laurapreidewe/Agriculture-VCU_v1/docs/Revision List.docx

Tractor VCU PCB Revision

Changes Made | Previous PCB | Current PCB

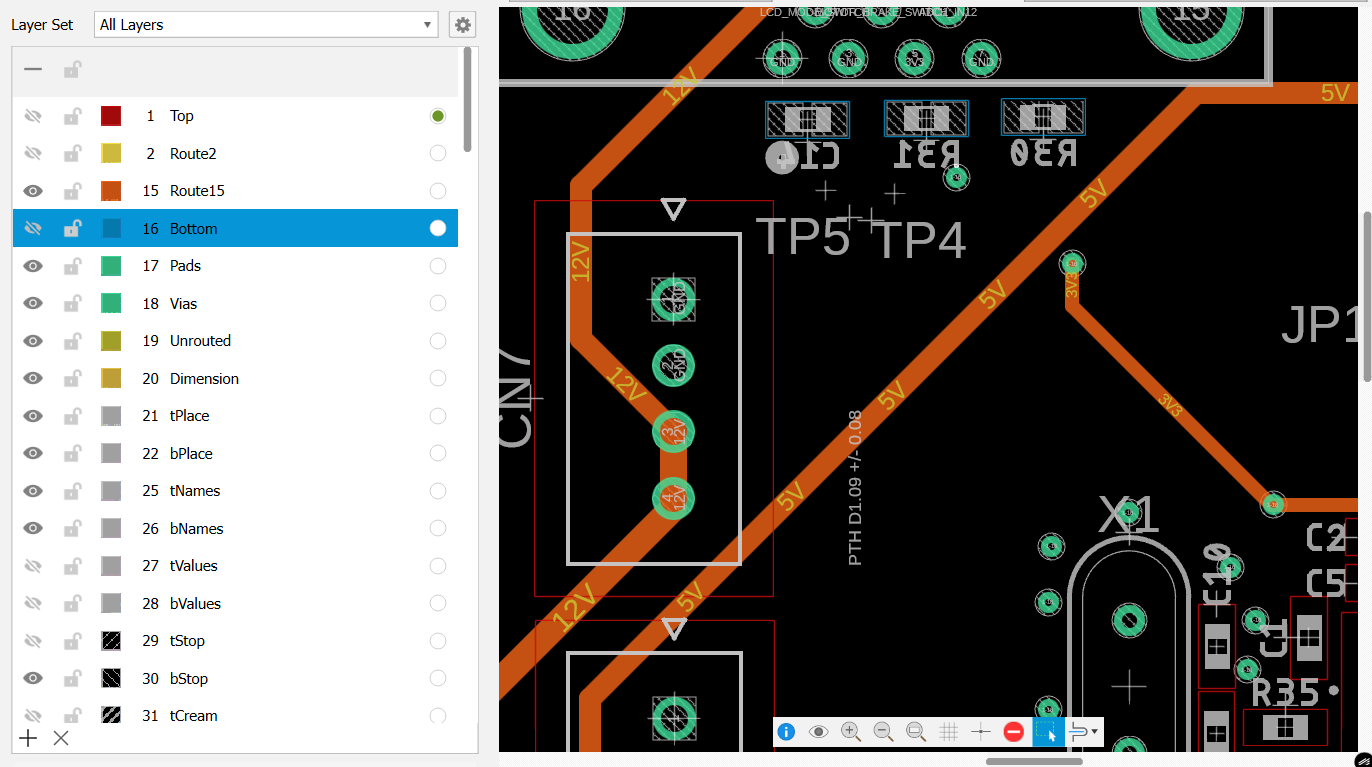
[picture p1: figure]
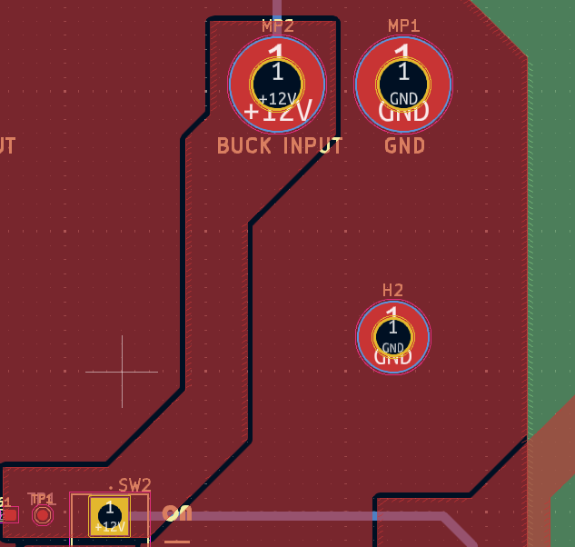
[picture p2: figure]
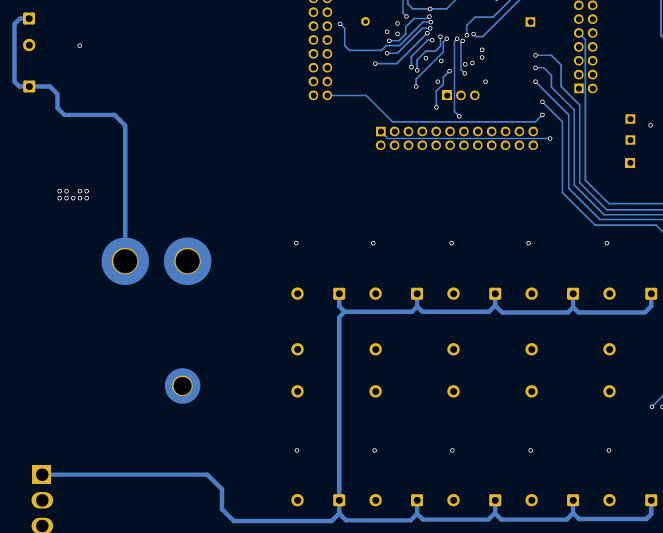
[picture p3: figure]

Move 12V route to outer layer¹ | (Circled in light blue)

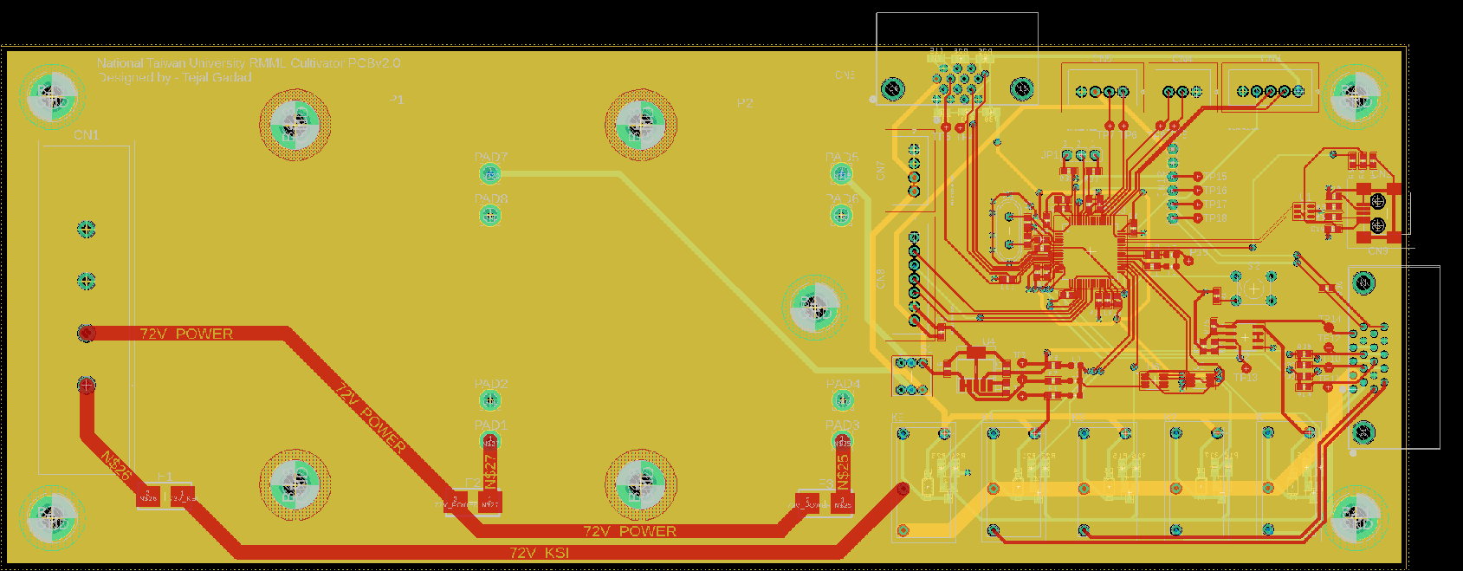
[picture p4: figure]
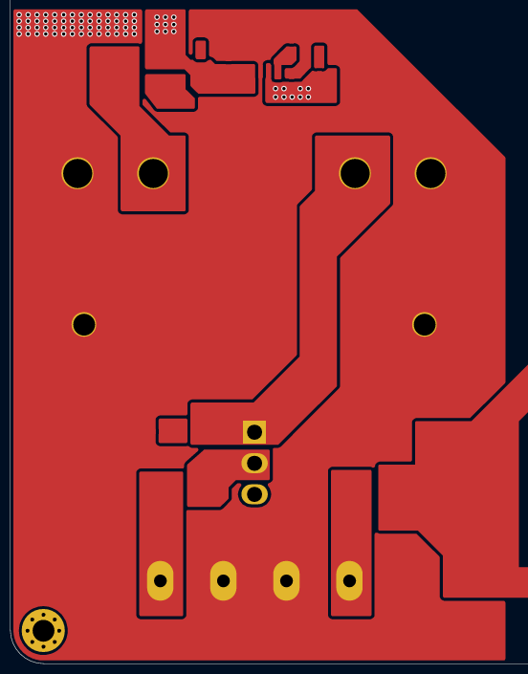
[picture p5: figure]
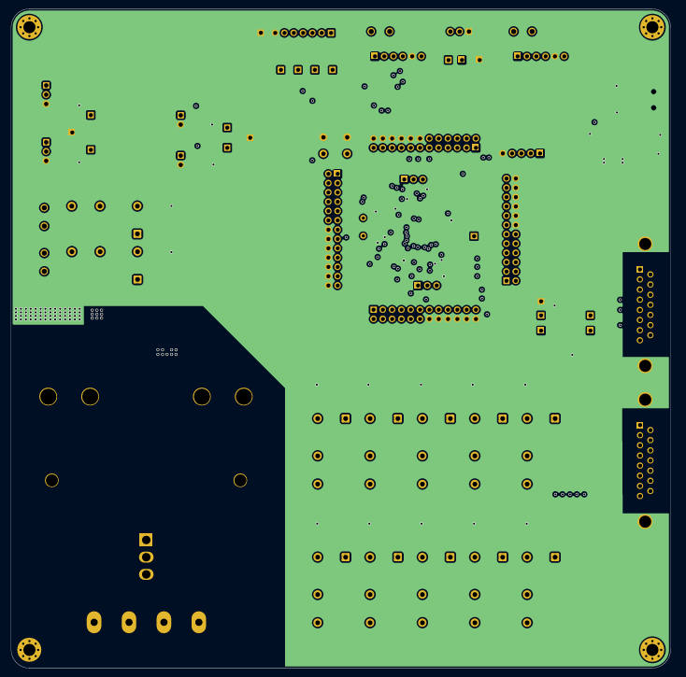
[picture p6: figure]

Separate ground plane for high and low-current¹ | | High current: Low current:

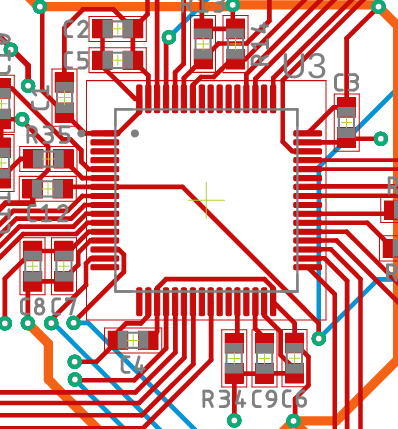
[picture p7: figure]
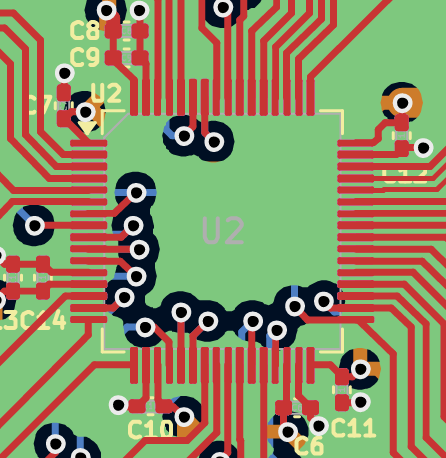
[picture p8: figure]

Component placement (STM32 decoupling capacitors) ¹²
Capacitor footprint size for STM32 circuit | 0603 | 0402
Resistor footprint size for STM32 circuit | 0603 | 0402

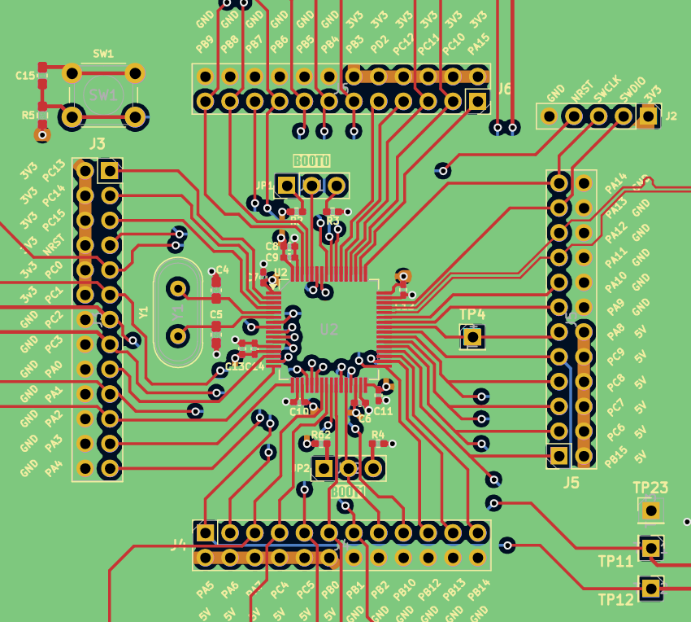
[picture p9: figure]

Add extension pins | N/A

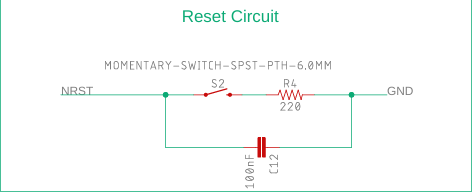
[picture p10: figure]
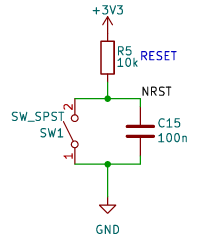
[picture p11: figure]

Fix reset circuit

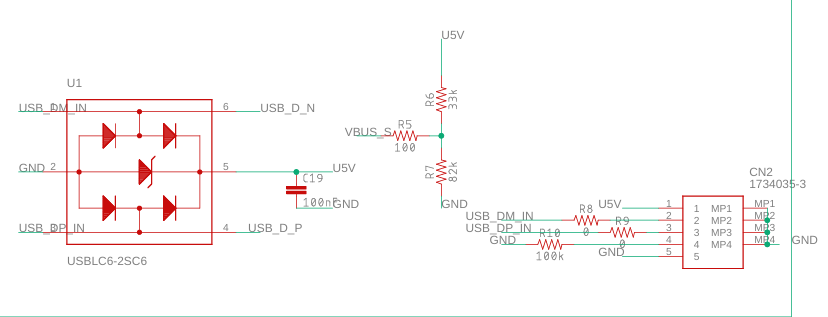
[picture p12: figure]
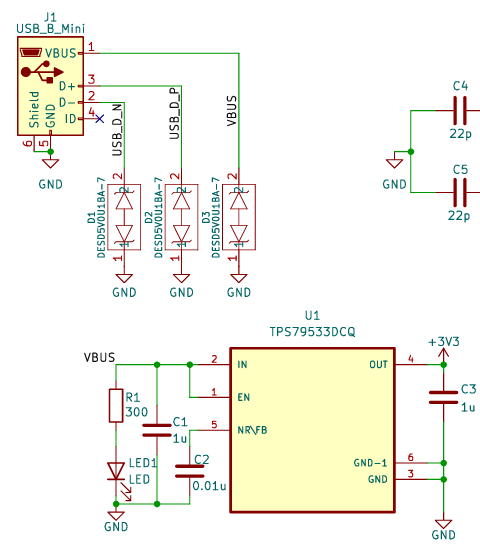
[picture p13: figure]

USB Circuit

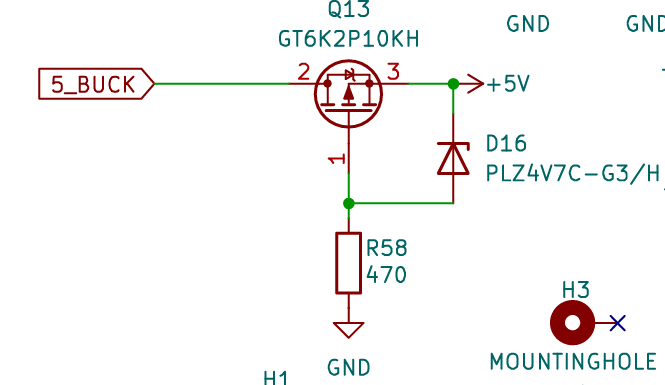
[picture p14: figure]

Add protection circuit (reverse voltage) | N/A
Add a ground point for test points³ | N/A

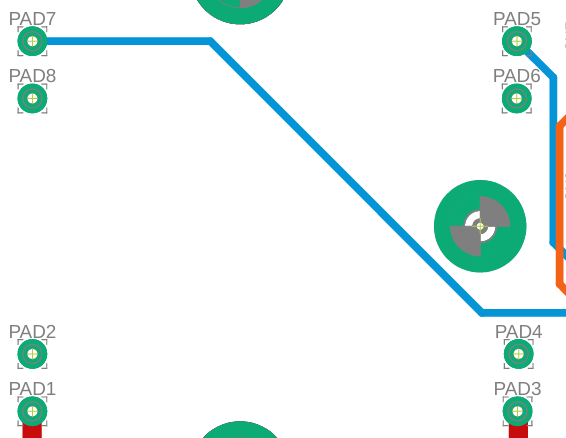
[picture p15: figure]
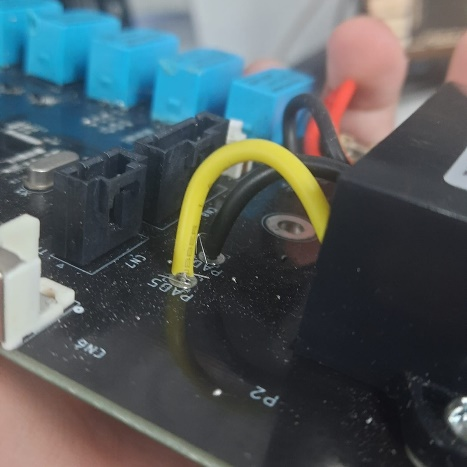
[picture p16: figure]
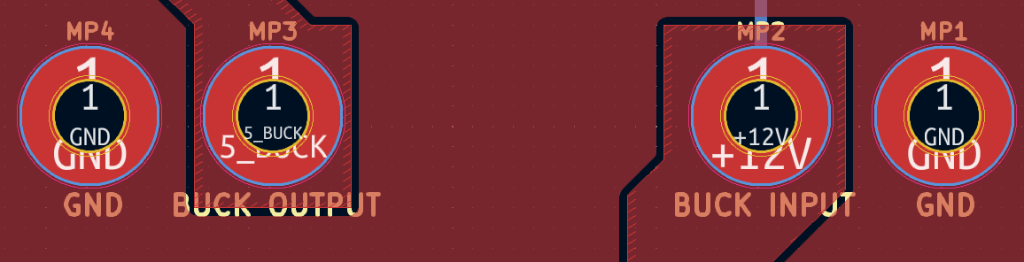
[picture p17: figure]
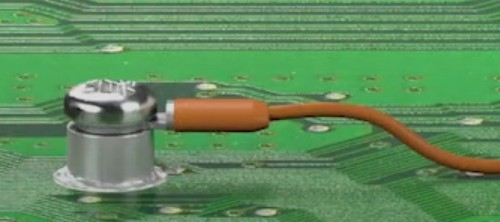
[picture p18: figure]

Change buck converters input and output connector | Connecting method: | Connecting method:

Notes:

¹Layer stacking:

Red: Top -> Signal + Power

Green: Inner layer 1 -> Ground

Orange: Inner layer 2 -> Power

Blue: Bottom -> Signal + Power

²Schematic for STM32 decoupling capacitors

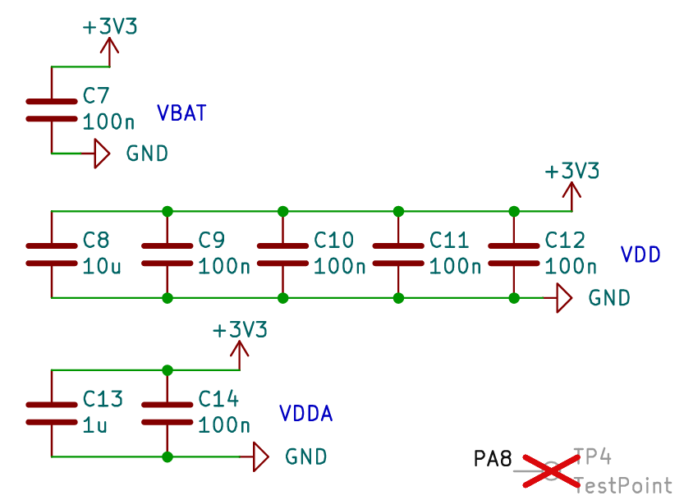
[picture p19: figure]

³Red cross is feature from KiCad to mark a component which is assigned as DNP (Do Not Place)
