laurapreidewe/Agriculture-VCU_v1/(list of files, cad)

Other CAD files:
Tractor VCU.step
