laurapreidewe/Agriculture-VCU_v1/Tractor VCU.kicad_pcb

## KiCad design Tractor VCU.kicad_pcb (2026-10-21)

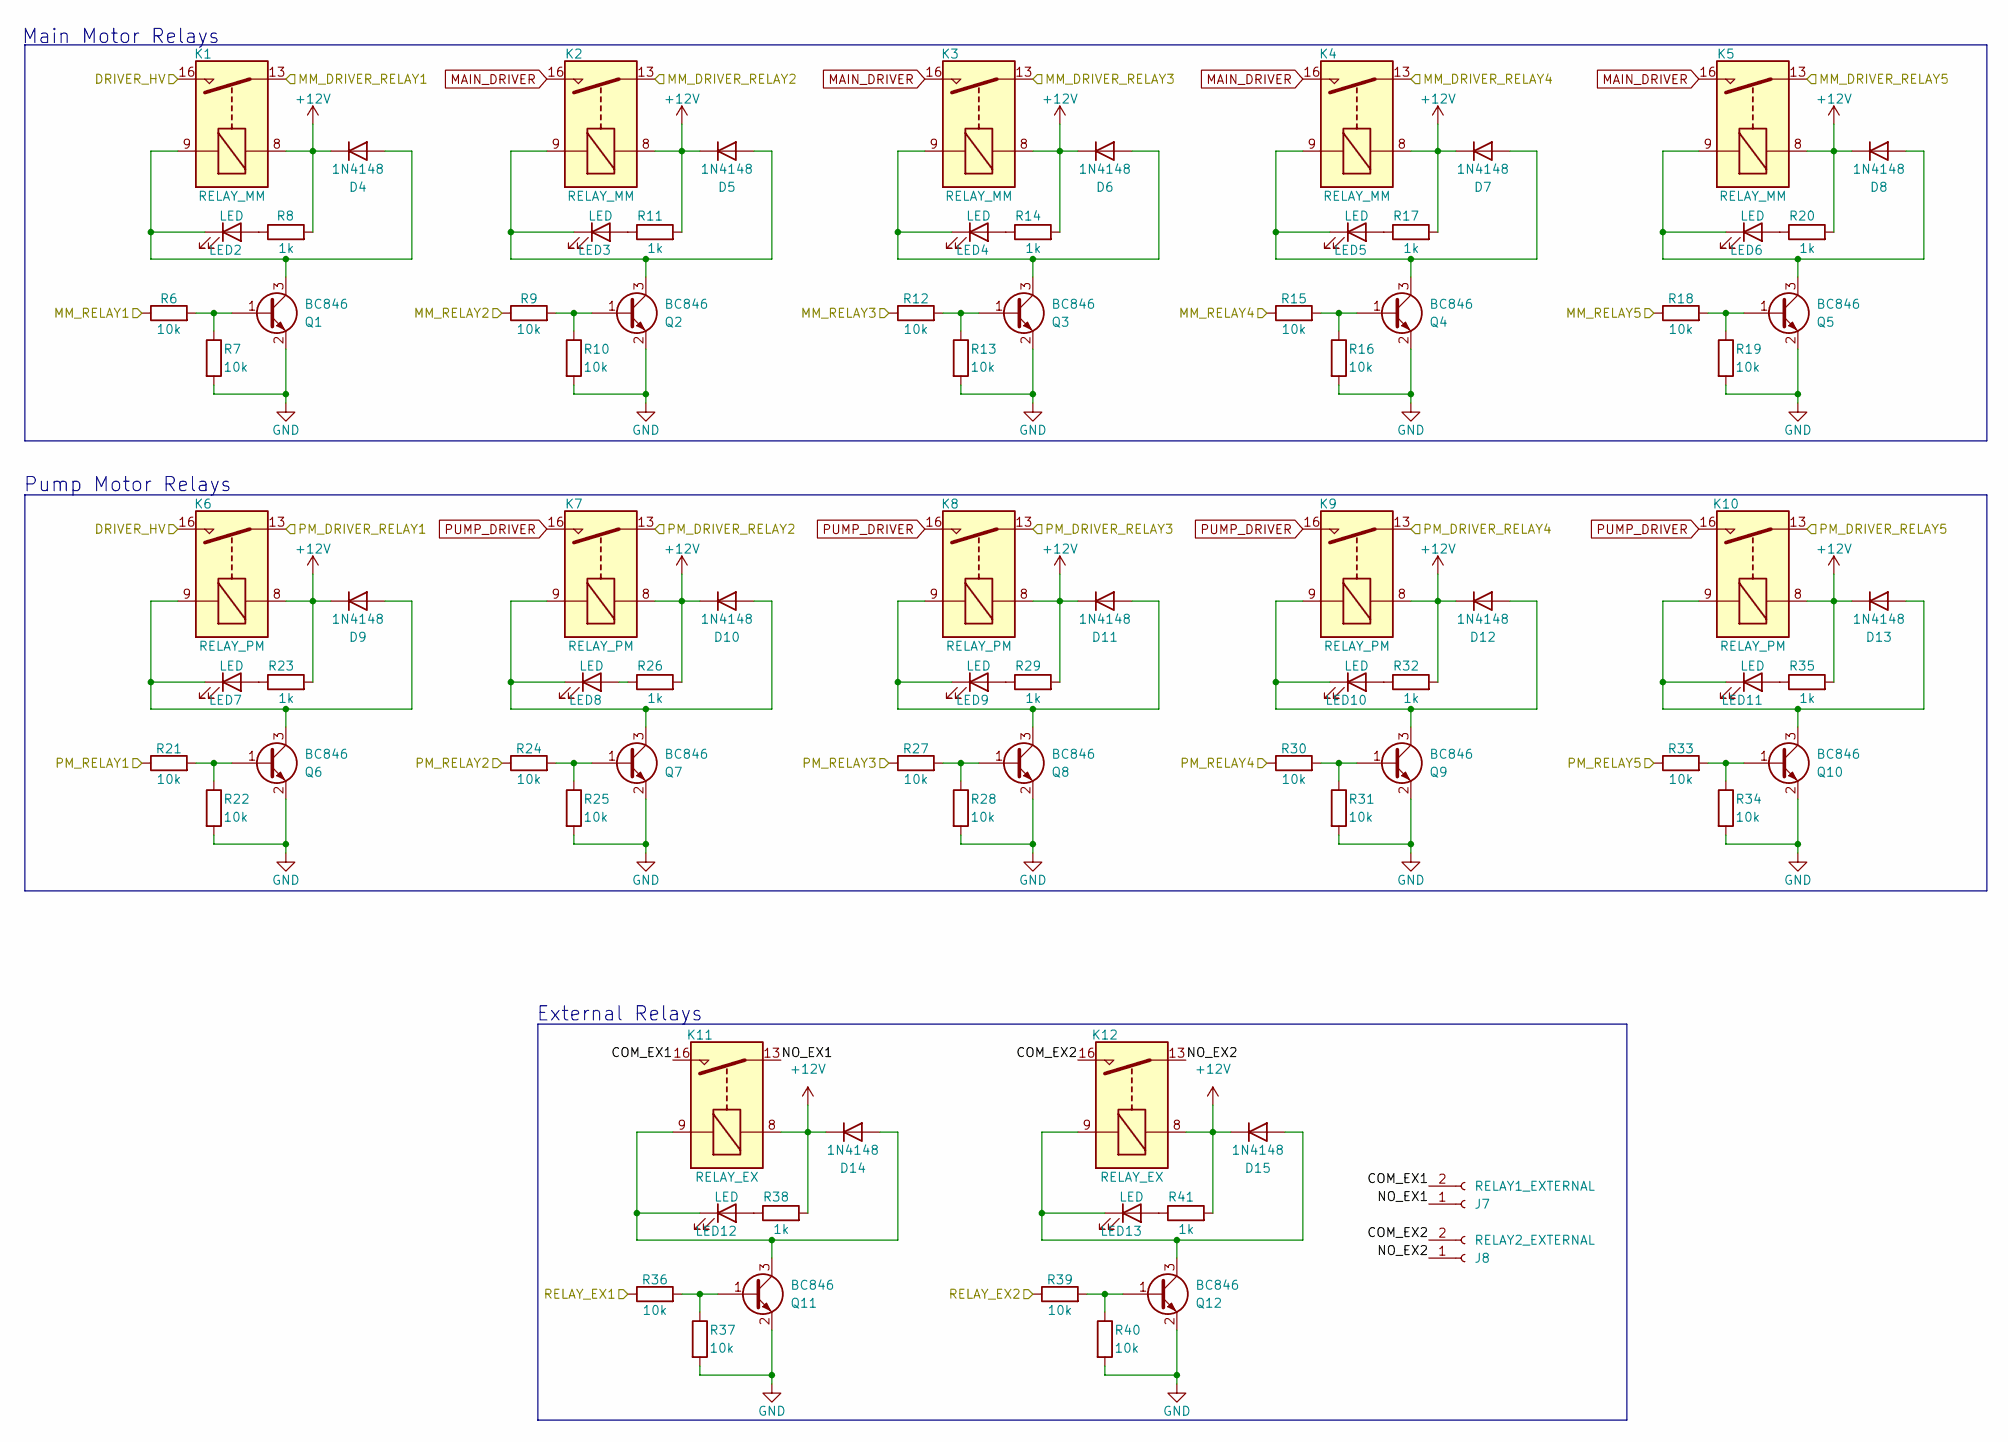
[picture p28: schematic VCU Relays.kicad_sch, Agriculture VCU]

Parts:
D4, D5, D6, D7, D8, D9, D10, D11, D12, D13, D14, D15: 1N4148; D_SOD-123; MANUFACTURER_PART_NUMBER 1N4148W-TP
J7: RELAY1_EXTERNAL; Wuerth_TBL_691137710002_1x02_P5mm; MANUFACTURER_PART_NUMBER 691137710002
J8: RELAY2_EXTERNAL; Wuerth_TBL_691137710002_1x02_P5mm; MANUFACTURER_PART_NUMBER 691137710002
K1, K2, K3, K4, K5: RELAY_MM; Relay_SPST_Fujitsu_JY-12H-K; MANUFACTURER_PART_NUMBER JY-12H-K
K6, K7, K8, K9, K10: RELAY_PM; Relay_SPST_Fujitsu_JY-12H-K; MANUFACTURER_PART_NUMBER JY-12H-K
K11, K12: RELAY_EX; Relay_SPST_Fujitsu_JY-12H-K; MANUFACTURER_PART_NUMBER JY-12H-K
LED2, LED3, LED4, LED5, LED6, LED7, LED8, LED9, LED10, LED11, LED12, LED13: LED; LED_0603_1608Metric_Pad1.05x0.95mm_HandSolder; MANUFACTURER_PART_NUMBER 150060SS75003
Q1, Q2, Q3, Q4, Q5, Q6, Q7, Q8, Q9, Q10, Q11, Q12: BC846; SOT-23; MANUFACTURER_PART_NUMBER BC846B,215
R6, R7, R9, R10, R12, R13, R15, R16, R18, R19, R21, R22, R24, R25, R27, R28, R30, R31, R33, R34, R36, R37, R39, R40: 10k; R_0603_1608Metric_Pad0.98x0.95mm_HandSolder; MANUFACTURER_PART_NUMBER RT0603FRE0710KL
R8, R11, R14, R17, R20, R23, R26, R29, R32, R35, R38, R41: 1k; R_0603_1608Metric_Pad0.98x0.95mm_HandSolder; MANUFACTURER_PART_NUMBER RT0603FRE131KL

Connections:
+12V: D4.1 (K), D5.1 (K), D6.1 (K), D7.1 (K), D8.1 (K), D9.1 (K), D10.1 (K), D11.1 (K), D12.1 (K), D13.1 (K), D14.1 (K), D15.1 (K), K1.8, K2.8, K3.8, K4.8, K5.8, K6.8, K7.8, K8.8, K9.8, K10.8, K11.8, K12.8, R8.2, R11.2, R14.2, R17.2, R20.2, R23.2, R26.2, R29.2, R32.2, R35.2, R38.2, R41.2; also elsewhere on the board
/DRIVER & CONNECTOR/DRIVER_MAIN1: K1.13; also elsewhere on the board
/DRIVER & CONNECTOR/DRIVER_MAIN2: K2.13; also elsewhere on the board
/DRIVER & CONNECTOR/DRIVER_MAIN3: K3.13; also elsewhere on the board
/DRIVER & CONNECTOR/DRIVER_MAIN4: K4.13; also elsewhere on the board
/DRIVER & CONNECTOR/DRIVER_MAIN5: K5.13; also elsewhere on the board
/DRIVER & CONNECTOR/DRIVER_PUMP1: K6.13; also elsewhere on the board
/DRIVER & CONNECTOR/DRIVER_PUMP2: K7.13; also elsewhere on the board
/DRIVER & CONNECTOR/DRIVER_PUMP3: K8.13; also elsewhere on the board
/DRIVER & CONNECTOR/DRIVER_PUMP4: K9.13; also elsewhere on the board
/DRIVER & CONNECTOR/DRIVER_PUMP5: K10.13; also elsewhere on the board
/POWER SUPPLY/72V: K1.16, K6.16; also elsewhere on the board
/RELAY/COM_EX1: J7.2, K11.16
/RELAY/COM_EX2: J8.2, K12.16
/RELAY/NO_EX1: J7.1, K11.13
/RELAY/NO_EX2: J8.1, K12.13
/STM32/PA1: R36.1; also elsewhere on the board
/STM32/PA2: R39.1; also elsewhere on the board
/STM32/PA7: R6.1; also elsewhere on the board
/STM32/PB0: R15.1; also elsewhere on the board
/STM32/PB1: R18.1; also elsewhere on the board
/STM32/PB15: R21.1; also elsewhere on the board
/STM32/PC4: R9.1; also elsewhere on the board
/STM32/PC5: R12.1; also elsewhere on the board
/STM32/PC6: R24.1; also elsewhere on the board
/STM32/PC7: R27.1; also elsewhere on the board
/STM32/PC8: R30.1; also elsewhere on the board
/STM32/PC9: R33.1; also elsewhere on the board
GND: Q1.2 (E), Q2.2 (E), Q3.2 (E), Q4.2 (E), Q5.2 (E), Q6.2 (E), Q7.2 (E), Q8.2 (E), Q9.2 (E), Q10.2 (E), Q11.2 (E), Q12.2 (E), R7.2, R10.2, R13.2, R16.2, R19.2, R22.2, R25.2, R28.2, R31.2, R34.2, R37.2, R40.2; also elsewhere on the board
MAIN_DRIVER: K2.16, K3.16, K4.16, K5.16; also elsewhere on the board
unnamed: D4.2 (A), K1.9, LED2.1 (K), Q1.3 (C)
unnamed: D5.2 (A), K2.9, LED3.1 (K), Q2.3 (C)
unnamed: D6.2 (A), K3.9, LED4.1 (K), Q3.3 (C)
unnamed: D7.2 (A), K4.9, LED5.1 (K), Q4.3 (C)
unnamed: D8.2 (A), K5.9, LED6.1 (K), Q5.3 (C)
unnamed: D9.2 (A), K6.9, LED7.1 (K), Q6.3 (C)
unnamed: D10.2 (A), K7.9, LED8.1 (K), Q7.3 (C)
unnamed: D11.2 (A), K8.9, LED9.1 (K), Q8.3 (C)
unnamed: D12.2 (A), K9.9, LED10.1 (K), Q9.3 (C)
unnamed: D13.2 (A), K10.9, LED11.1 (K), Q10.3 (C)
unnamed: D14.2 (A), K11.9, LED12.1 (K), Q11.3 (C)
unnamed: D15.2 (A), K12.9, LED13.1 (K), Q12.3 (C)
unnamed: LED2.2 (A), R8.1
unnamed: LED3.2 (A), R11.1
unnamed: LED4.2 (A), R14.1
unnamed: LED5.2 (A), R17.1
unnamed: LED6.2 (A), R20.1
unnamed: LED7.2 (A), R23.1
unnamed: LED8.2 (A), R26.1
unnamed: LED9.2 (A), R29.1
unnamed: LED10.2 (A), R32.1
unnamed: LED11.2 (A), R35.1
unnamed: LED12.2 (A), R38.1
unnamed: LED13.2 (A), R41.1
unnamed: Q1.1 (B), R6.2, R7.1
unnamed: Q2.1 (B), R9.2, R10.1
unnamed: Q3.1 (B), R12.2, R13.1
unnamed: Q4.1 (B), R15.2, R16.1
unnamed: Q5.1 (B), R18.2, R19.1
unnamed: Q6.1 (B), R21.2, R22.1
unnamed: Q7.1 (B), R24.2, R25.1
unnamed: Q8.1 (B), R27.2, R28.1
unnamed: Q9.1 (B), R30.2, R31.1
unnamed: Q10.1 (B), R33.2, R34.1
unnamed: Q11.1 (B), R36.2, R37.1
unnamed: Q12.1 (B), R39.2, R40.1
PUMP_DRIVER: K7.16, K8.16, K9.16, K10.16; also elsewhere on the board

Notes on the sheet:
Main Motor Relays
Pump Motor Relays
External Relays

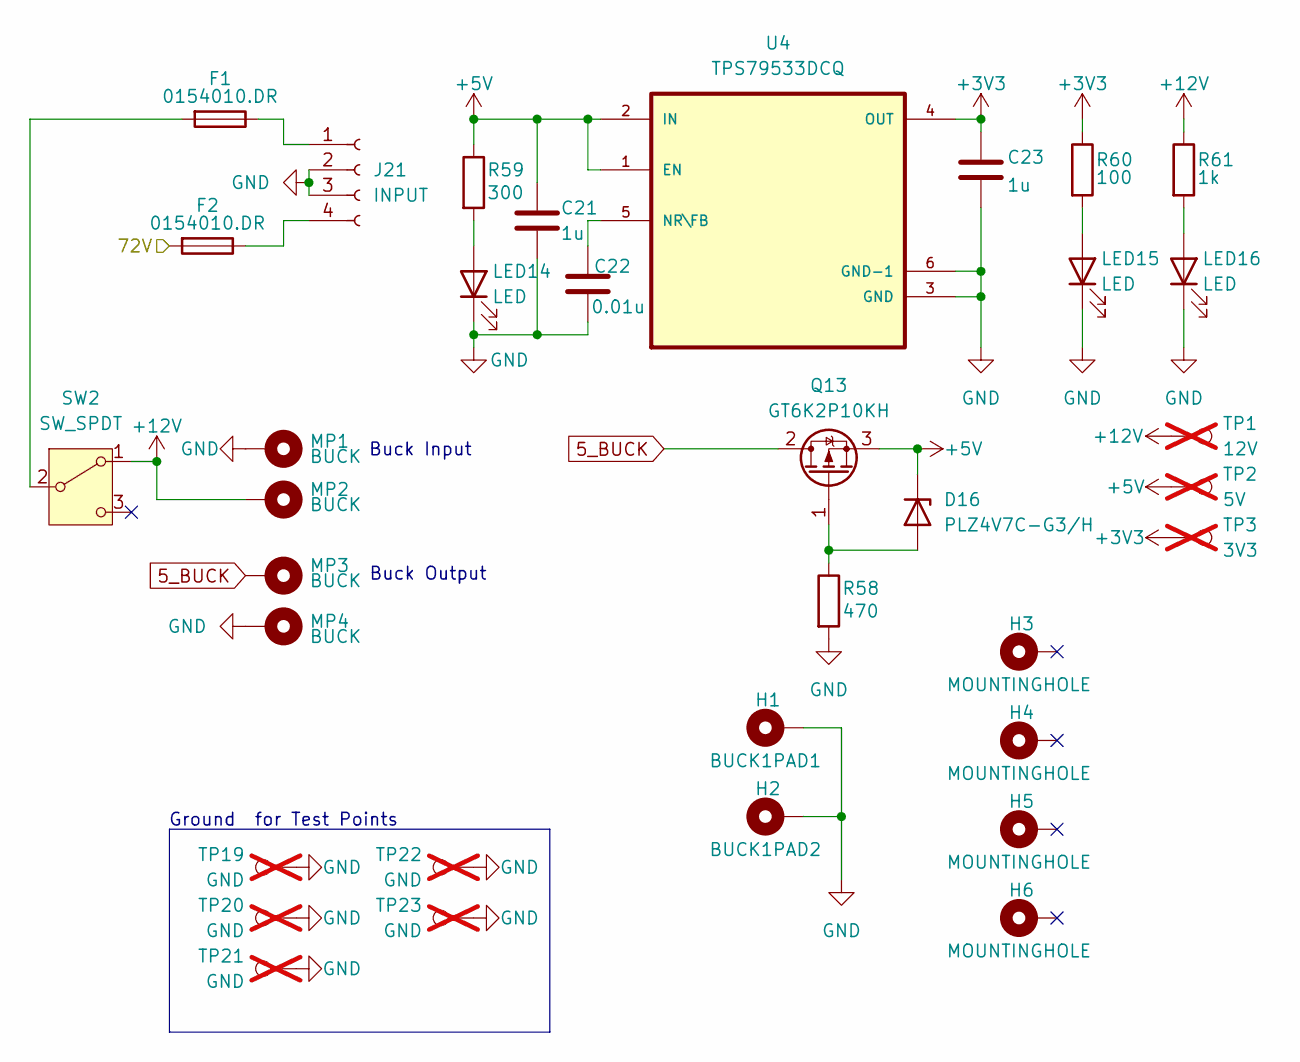
[picture p29: schematic power supply.kicad_sch, Agriculture VCU]

Parts:
C21, C23: 1u; C_0603_1608Metric_Pad1.08x0.95mm_HandSolder; MANUFACTURER_PART_NUMBER 0603YC105JAT2A
C22: 0.01u; C_0603_1608Metric_Pad1.08x0.95mm_HandSolder; MANUFACTURER_PART_NUMBER KGM15AR51E103KT
D16: PLZ4V7C-G3/H; CR_PLZ5V1C_VIS-L; MANUFACTURER_PART_NUMBER PLZ4V7C
F1, F2: 0154010.DR; Fuseholder_Littelfuse_Nano2_154x; MANUFACTURER_PART_NUMBER 0154010.DR
H1: BUCK1PAD1; MountingHole_3.2mm_M3_Pad_TopBottom
H2: BUCK1PAD2; MountingHole_3.2mm_M3_Pad_TopBottom
H3, H4, H5, H6: MOUNTINGHOLE; MountingHole_3.2mm_M3_Pad_Via
J21: INPUT; Molex_38720-6304; MANUFACTURER_PART_NUMBER 0387206304
LED14, LED15, LED16: LED; LED_0603_1608Metric_Pad1.05x0.95mm_HandSolder; MANUFACTURER_PART_NUMBER 150060SS75003
MP1, MP2, MP3, MP4: BUCK; MountingHole_4.3mm_M4_Pad_TopBottom; MANUFACTURER_PART_NUMBER 24885
Q13: GT6K2P10KH; TO-252-2; MANUFACTURER_PART_NUMBER GT6K2P10KH
R58: 470; R_0603_1608Metric_Pad0.98x0.95mm_HandSolder; MANUFACTURER_PART_NUMBER RT0603FRE07470RL
R59: 300; R_0603_1608Metric_Pad0.98x0.95mm_HandSolder; MANUFACTURER_PART_NUMBER CPF0603B300RE1
R60: 100; R_0603_1608Metric_Pad0.98x0.95mm_HandSolder; MANUFACTURER_PART_NUMBER RP0603BRD07100RL
R61: 1k; R_0603_1608Metric_Pad0.98x0.95mm_HandSolder; MANUFACTURER_PART_NUMBER RT0603FRE131KL
SW2: SW_SPDT; SW_500SSP1S1M2REA; MANUFACTURER_PART_NUMBER ANT11SECQE
TP1: 12V; TestPoint_Pad_D1.0mm; not fitted
TP2: 5V; TestPoint_Pad_D1.0mm; not fitted
TP3: 3V3; TestPoint_Pad_D1.0mm; not fitted
TP19, TP20, TP21, TP22, TP23: GND; PinHeader_1x01_P2.54mm_Vertical; not fitted
U4: TPS79533DCQ; SOT127P706X180-6N; MANUFACTURER_PART_NUMBER TPS79533DCQ

Connections:
5_BUCK: MP3.1 (1_1), Q13.2 (D)
+3V3: C23.1, R60.1, TP3.1 (1_1), U4.4 (OUT); also elsewhere on the board
+5V: C21.1, D16.1 (K), Q13.3 (S), R59.1, TP2.1 (1_1), U4.1 (EN), U4.2 (IN); also elsewhere on the board
+12V: MP2.1 (1_1), R61.1, SW2.1 (A), TP1.1 (1_1); also elsewhere on the board
/POWER SUPPLY/72V: F2.2; also elsewhere on the board
GND: C21.2, C22.2, C23.2, H1.1 (1_1), H2.1 (1_1), J21.2, J21.3, LED14.1 (K), LED15.1 (K), LED16.1 (K), MP1.1 (1_1), MP4.1 (1_1), R58.2, TP19.1 (1_1), TP20.1 (1_1), TP21.1 (1_1), TP22.1 (1_1), TP23.1 (1_1), U4.3 (GND), U4.6 (GND-1); also elsewhere on the board
unnamed: D16.2 (A), Q13.1 (G), R58.1
unnamed: F1.1, J21.1
unnamed: F2.1, J21.4
unnamed: LED14.2 (A), R59.2
unnamed: LED15.2 (A), R60.2
unnamed: LED16.2 (A), R61.2
unnamed: F1.2, SW2.2 (B)
unnamed: C22.1, U4.5 (NR\FB)

Notes on the sheet:
Buck Input
Ground for Test Points
Buck Output

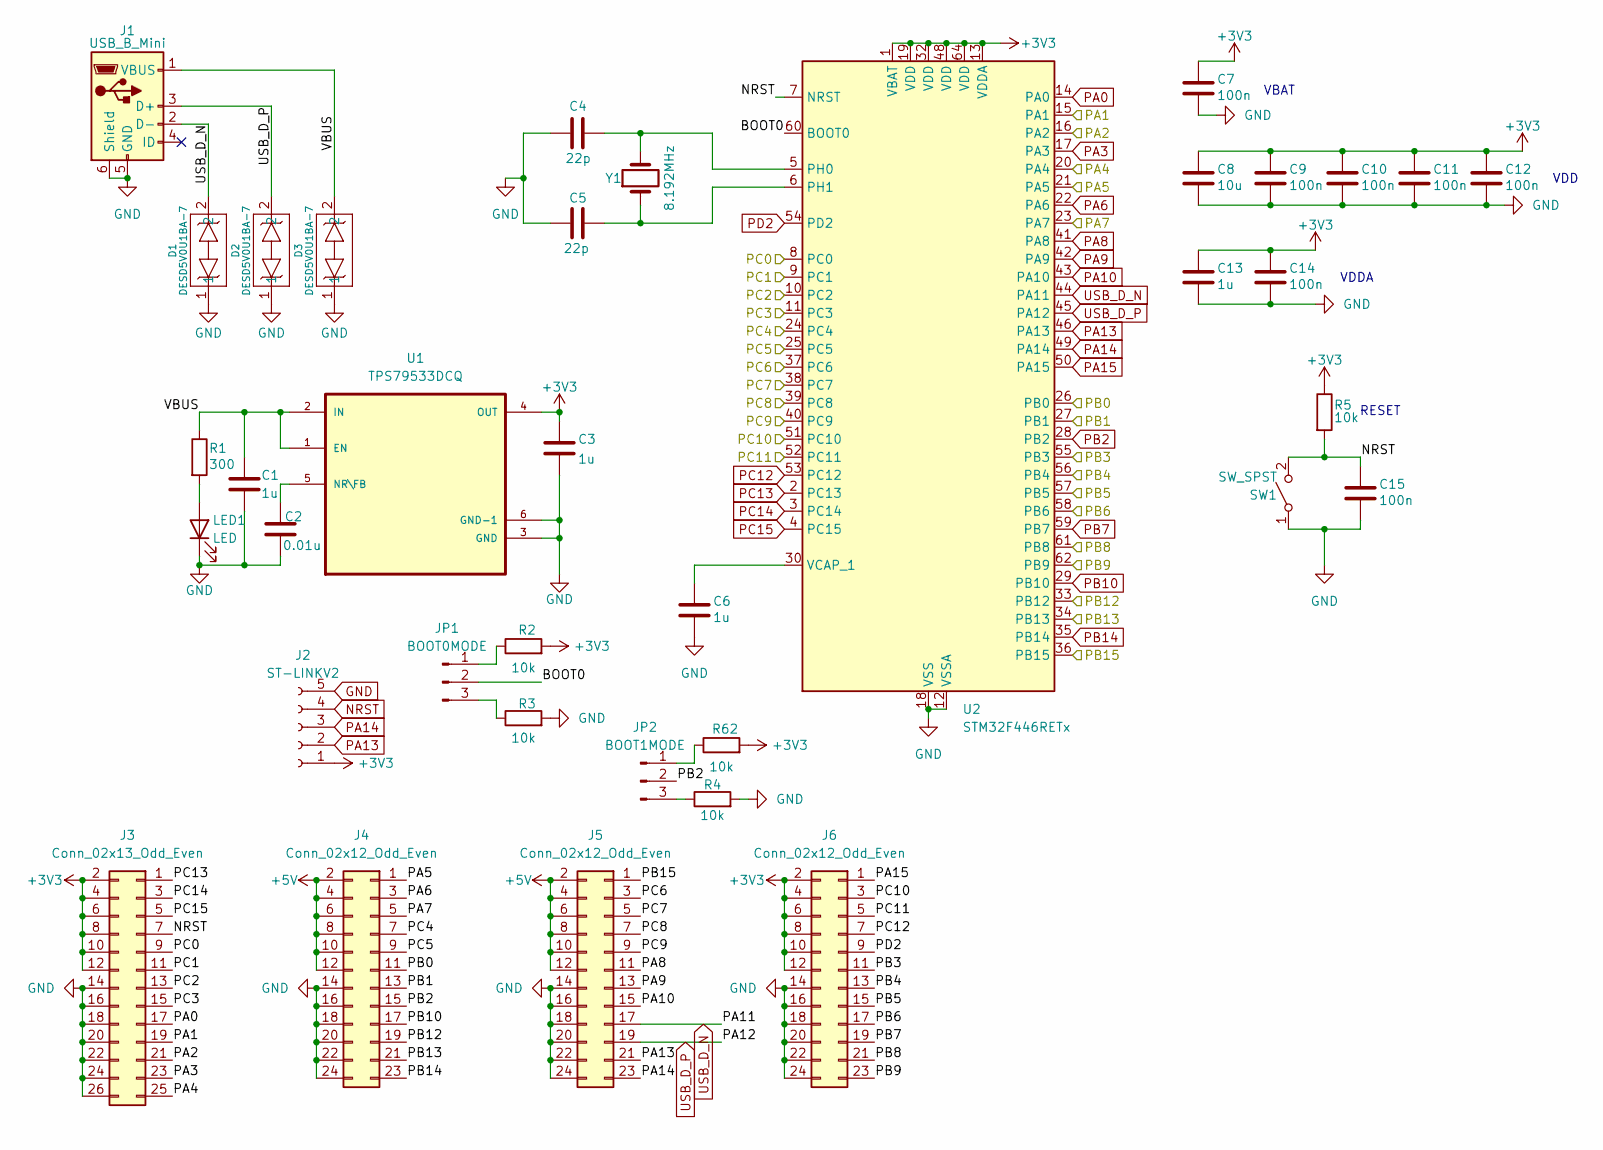
[picture p30: schematic STM32F446RE minsys.kicad_sch, Agriculture VCU]

Parts:
C1, C3: 1u; C_0603_1608Metric_Pad1.08x0.95mm_HandSolder; MANUFACTURER_PART_NUMBER 0603YC105JAT2A
C2: 0.01u; C_0603_1608Metric_Pad1.08x0.95mm_HandSolder; MANUFACTURER_PART_NUMBER KGM15AR51E103KT
C4, C5: 22p; C_0603_1608Metric_Pad1.08x0.95mm_HandSolder; MANUFACTURER_PART_NUMBER 06035A220JAT2A
C6, C13: 1u; C_0402_1005Metric_Pad0.74x0.62mm_HandSolder; MANUFACTURER_PART_NUMBER GRM155R70J105KA12D
C7, C9, C10, C11, C12, C14: 100n; C_0402_1005Metric_Pad0.74x0.62mm_HandSolder; MANUFACTURER_PART_NUMBER GRM155R71C104KA88J
C8: 10u; C_0402_1005Metric_Pad0.74x0.62mm_HandSolder; MANUFACTURER_PART_NUMBER GRM155R61A106ME11D
C15: 100n; C_0603_1608Metric_Pad1.08x0.95mm_HandSolder; MANUFACTURER_PART_NUMBER KGM15BR71H104KT
D1, D2, D3: DESD5V0U1BA-7; SOD323-L_DIO-M; MANUFACTURER_PART_NUMBER DESD5V0U1BA
J1: USB_B_Mini; USB_Mini-B_Wuerth_65100516121_Horizontal; MANUFACTURER_PART_NUMBER 1734035-3
J2: ST-LINKV2; PinHeader_1x05_P2.54mm_Vertical; MANUFACTURER_PART_NUMBER PH1-05-UA
J3: Conn_02x13_Odd_Even; PinSocket_2x13_P2.54mm_Vertical; MANUFACTURER_PART_NUMBER 61302621821
J4, J5, J6: Conn_02x12_Odd_Even; PinSocket_2x12_P2.54mm_Vertical; MANUFACTURER_PART_NUMBER PPTC122LFBN-RC
JP1: BOOT0MODE; PinHeader_1x03_P2.54mm_Vertical; MANUFACTURER_PART_NUMBER 90120-0923
JP2: BOOT1MODE; PinHeader_1x03_P2.54mm_Vertical; MANUFACTURER_PART_NUMBER 90120-0923
LED1: LED; LED_0603_1608Metric_Pad1.05x0.95mm_HandSolder; MANUFACTURER_PART_NUMBER 150060SS75003
R1: 300; R_0603_1608Metric_Pad0.98x0.95mm_HandSolder; MANUFACTURER_PART_NUMBER CPF0603B300RE1
R2, R3, R4, R62: 10k; R_0402_1005Metric_Pad0.72x0.64mm_HandSolder; MANUFACTURER_PART_NUMBER RT0402FRE0710KL
R5: 10k; R_0603_1608Metric_Pad0.98x0.95mm_HandSolder; MANUFACTURER_PART_NUMBER RT0603FRE0710KL
SW1: SW_SPST; SW_PUSH_6mm; MANUFACTURER_PART_NUMBER TL1105F160QWITHSTRAIGHT
U1: TPS79533DCQ; SOT127P706X180-6N; MANUFACTURER_PART_NUMBER TPS79533DCQ
U2: STM32F446RETx; LQFP-64_10x10mm_P0.5mm; MANUFACTURER_PART_NUMBER STM32F446RET6
Y1: 8.192MHz; Crystal_HC49-U_Vertical; MANUFACTURER_PART_NUMBER ABL-8.000MHZ-B2

Connections:
+3V3: C3.1, C7.1, C8.1, C9.1, C10.1, C11.1, C12.1, C13.1, C14.1, J2.1, J3.2, J3.4, J3.6, J3.8, J3.10, J3.12, J6.2, J6.4, J6.6, J6.8, J6.10, J6.12, R2.2, R5.1, R62.2, U1.4 (OUT), U2.1 (VBAT), U2.13 (VDDA), U2.19 (VDD), U2.32 (VDD), U2.48 (VDD), U2.64 (VDD); also elsewhere on the board
+5V: J4.2, J4.4, J4.6, J4.8, J4.10, J4.12, J5.2, J5.4, J5.6, J5.8, J5.10, J5.12; also elsewhere on the board
/DRIVER & CONNECTOR/ADC1_IN12: J3.13, U2.10 (PC2); also elsewhere on the board
/DRIVER & CONNECTOR/ADC1_IN13: J3.15, U2.11 (PC3); also elsewhere on the board
/DRIVER & CONNECTOR/BRAKE1_IN: J3.9, U2.8 (PC0); also elsewhere on the board
/DRIVER & CONNECTOR/BRAKE2_IN: J3.11, U2.9 (PC1); also elsewhere on the board
/DRIVER & CONNECTOR/DAC1_OUT: J3.25, U2.20 (PA4); also elsewhere on the board
/DRIVER & CONNECTOR/DAC2_OUT: J4.1, U2.21 (PA5); also elsewhere on the board
/DRIVER & CONNECTOR/SPI1_CS: J6.17, U2.58 (PB6); also elsewhere on the board
/DRIVER & CONNECTOR/SPI1_MISO: J6.13, U2.56 (PB4); also elsewhere on the board
/DRIVER & CONNECTOR/SPI1_MOSI: J6.15, U2.57 (PB5); also elsewhere on the board
/DRIVER & CONNECTOR/SPI1_SCK: J6.11, U2.55 (PB3); also elsewhere on the board
/DRIVER & CONNECTOR/USART3_RX: J6.5, U2.52 (PC11); also elsewhere on the board
/DRIVER & CONNECTOR/USART3_TX: J6.3, U2.51 (PC10); also elsewhere on the board
/STM32/BOOT0: JP1.2, U2.60 (BOOT0)
/STM32/PA1: J3.19, U2.15 (PA1); also elsewhere on the board
/STM32/PA2: J3.21, U2.16 (PA2); also elsewhere on the board
/STM32/PA7: J4.5, U2.23 (PA7); also elsewhere on the board
/STM32/PB0: J4.11, U2.26 (PB0); also elsewhere on the board
/STM32/PB1: J4.13, U2.27 (PB1); also elsewhere on the board
/STM32/PB8: J6.21, U2.61 (PB8); also elsewhere on the board
/STM32/PB9: J6.23, U2.62 (PB9); also elsewhere on the board
/STM32/PB12: J4.19, U2.33 (PB12); also elsewhere on the board
/STM32/PB13: J4.21, U2.34 (PB13); also elsewhere on the board
/STM32/PB15: J5.1, U2.36 (PB15); also elsewhere on the board
/STM32/PC4: J4.7, U2.24 (PC4); also elsewhere on the board
/STM32/PC5: J4.9, U2.25 (PC5); also elsewhere on the board
/STM32/PC6: J5.3, U2.37 (PC6); also elsewhere on the board
/STM32/PC7: J5.5, U2.38 (PC7); also elsewhere on the board
/STM32/PC8: J5.7, U2.39 (PC8); also elsewhere on the board
/STM32/PC9: J5.9, U2.40 (PC9); also elsewhere on the board
/STM32/VBUS: C1.1, D3.2, J1.1 (VBUS), R1.1, U1.1 (EN), U1.2 (IN)
GND: C1.2, C2.2, C3.2, C4.2, C5.2, C6.2, C7.2, C8.2, C9.2, C10.2, C11.2, C12.2, C13.2, C14.2, C15.2, D1.1, D2.1, D3.1, J1.5 (GND), J1.6 (Shield), J2.5, J3.14, J3.16, J3.18, J3.20, J3.22, J3.24, J3.26, J4.14, J4.16, J4.18, J4.20, J4.22, J4.24, J5.14, J5.16, J5.18, J5.20, J5.22, J5.24, J6.14, J6.16, J6.18, J6.20, J6.22, J6.24, LED1.1 (K), R3.2, R4.2, SW1.1 (A), U1.3 (GND), U1.6 (GND-1), U2.12 (VSSA), U2.18 (VSS), U2.31 (VSS), U2.47 (VSS), U2.63 (VSS); also elsewhere on the board
NRST: C15.1, J2.4, J3.7, R5.2, SW1.2 (B), U2.7 (NRST)
unnamed: JP1.1, R2.1
unnamed: JP1.3, R3.1
unnamed: JP2.1, R62.1
unnamed: JP2.3, R4.1
unnamed: LED1.2 (A), R1.2
unnamed: C2.1, U1.5 (NR\FB)
unnamed: C4.1, U2.5 (PH0), Y1.2
unnamed: C5.1, U2.6 (PH1), Y1.1
unnamed: C6.1, U2.30 (VCAP_1)
PA0: J3.17, U2.14 (PA0)
PA3: J3.23, U2.17 (PA3)
PA6: J4.3, U2.22 (PA6)
PA8: J5.11, U2.41 (PA8); also elsewhere on the board
PA9: J5.13, U2.42 (PA9)
PA10: J5.15, U2.43 (PA10)
PA13: J2.2, J5.21, U2.46 (PA13)
PA14: J2.3, J5.23, U2.49 (PA14)
PA15: J6.1, U2.50 (PA15)
PB2: J4.15, JP2.2, U2.28 (PB2)
PB7: J6.19, U2.59 (PB7)
PB10: J4.17, U2.29 (PB10)
PB14: J4.23, U2.35 (PB14)
PC12: J6.7, U2.53 (PC12)
PC13: J3.1, U2.2 (PC13)
PC14: J3.3, U2.3 (PC14)
PC15: J3.5, U2.4 (PC15)
PD2: J6.9, U2.54 (PD2)
USB_D_N: D1.2, J1.2 (D-), J5.17, U2.44 (PA11)
USB_D_P: D2.2, J1.3 (D+), J5.19, U2.45 (PA12)

Notes on the sheet:
VDDA
VDD
RESET
VBAT

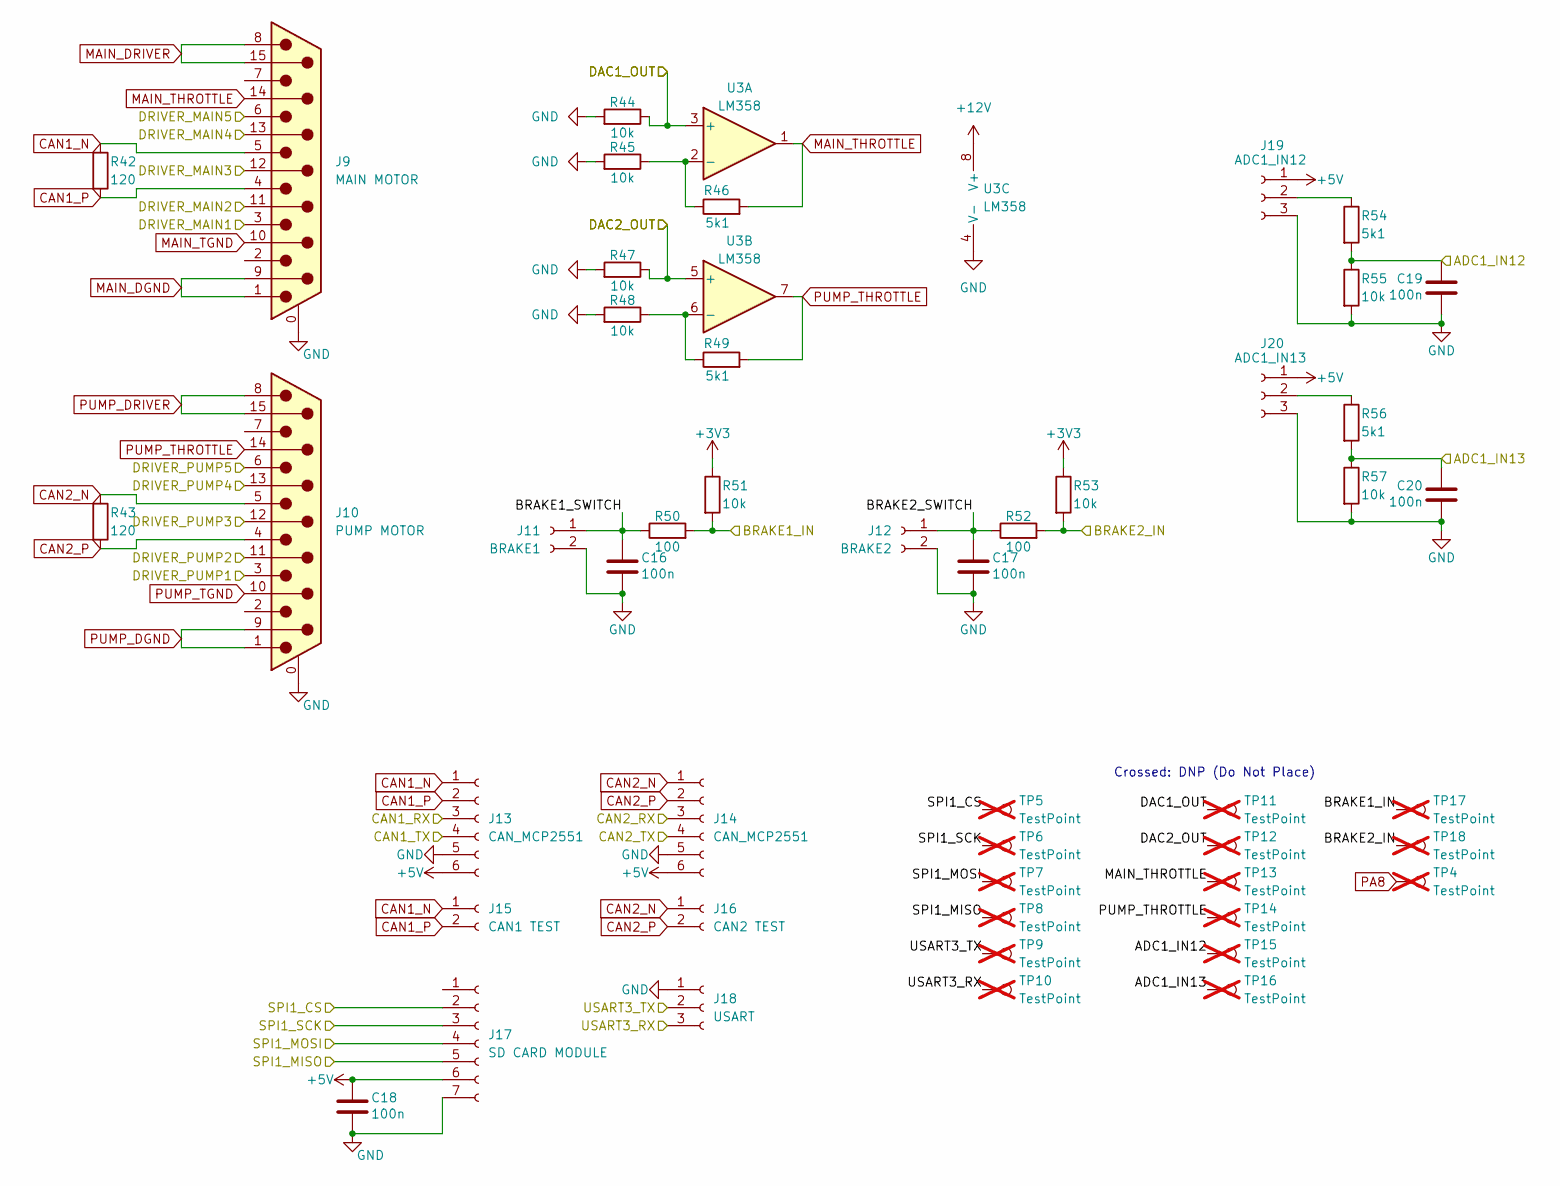
[picture p31: schematic VCU Connectors.kicad_sch, Agriculture VCU]

Parts:
C16, C17, C18, C19, C20: 100n; C_0603_1608Metric_Pad1.08x0.95mm_HandSolder; MANUFACTURER_PART_NUMBER KGM15BR71H104KT
J9: MAIN MOTOR; DSUB-15_Female_Vertical_P2.77x2.84mm_MountingHoles; MANUFACTURER_PART_NUMBER 1-5747299-6
J10: PUMP MOTOR; DSUB-15_Female_Vertical_P2.77x2.84mm_MountingHoles; MANUFACTURER_PART_NUMBER 1-5747299-6
J11: BRAKE1; Molex_SL_171971-0002_1x02_P2.54mm_Vertical; MANUFACTURER_PART_NUMBER 1719710002
J12: BRAKE2; Molex_SL_171971-0002_1x02_P2.54mm_Vertical; MANUFACTURER_PART_NUMBER 1719710002
J13, J14: CAN_MCP2551; PinSocket_1x06_P2.54mm_Vertical; MANUFACTURER_PART_NUMBER 61300611821
J15: CAN1 TEST; Wuerth_TBL_691137710002_1x02_P5mm; MANUFACTURER_PART_NUMBER 691137710002
J16: CAN2 TEST; Wuerth_TBL_691137710002_1x02_P5mm; MANUFACTURER_PART_NUMBER 691137710002
J17: SD CARD MODULE; PinSocket_1x07_P2.54mm_Vertical; MANUFACTURER_PART_NUMBER RS1-07-G
J18: USART; Molex_SL_171971-0003_1x03_P2.54mm_Vertical; MANUFACTURER_PART_NUMBER 1719710003
J19: ADC1_IN12; Molex_SL_171971-0003_1x03_P2.54mm_Vertical; MANUFACTURER_PART_NUMBER 1719710003
J20: ADC1_IN13; Molex_SL_171971-0003_1x03_P2.54mm_Vertical; MANUFACTURER_PART_NUMBER 1719710003
R42, R43: 120; R_0603_1608Metric_Pad0.98x0.95mm_HandSolder; MANUFACTURER_PART_NUMBER RT0603FRE13120RL
R44, R45, R47, R48, R51, R53, R55, R57: 10k; R_0603_1608Metric_Pad0.98x0.95mm_HandSolder; MANUFACTURER_PART_NUMBER RT0603FRE0710KL
R46, R49, R54, R56: 5k1; R_0603_1608Metric_Pad0.98x0.95mm_HandSolder; MANUFACTURER_PART_NUMBER RP0603BRD075K1L
R50, R52: 100; R_0603_1608Metric_Pad0.98x0.95mm_HandSolder; MANUFACTURER_PART_NUMBER RP0603BRD07100RL
TP4, TP5, TP6, TP7, TP8, TP9, TP10, TP11, TP12, TP13, TP14, TP15, TP16, TP17, TP18: TestPoint; PinHeader_1x01_P2.54mm_Vertical; not fitted
U3: LM358; SOIC-8_3.9x4.9mm_P1.27mm; MANUFACTURER_PART_NUMBER LM358M/NOPB

Connections:
+3V3: R51.1, R53.1; also elsewhere on the board
+5V: C18.1, J13.6, J14.6, J17.6, J19.1, J20.1; also elsewhere on the board
+12V: U3.8 (V+); also elsewhere on the board
/DRIVER & CONNECTOR/ADC1_IN12: C19.1, R54.2, R55.1, TP15.1 (1_1); also elsewhere on the board
/DRIVER & CONNECTOR/ADC1_IN13: C20.1, R56.2, R57.1, TP16.1 (1_1); also elsewhere on the board
/DRIVER & CONNECTOR/BRAKE1_IN: R50.2, R51.2, TP17.1 (1_1); also elsewhere on the board
/DRIVER & CONNECTOR/BRAKE1_SWITCH: C16.1, J11.1, R50.1
/DRIVER & CONNECTOR/BRAKE2_IN: R52.2, R53.2, TP18.1 (1_1); also elsewhere on the board
/DRIVER & CONNECTOR/BRAKE2_SWITCH: C17.1, J12.1, R52.1
/DRIVER & CONNECTOR/DAC1_OUT: R44.1, TP11.1 (1_1), U3.3 (+); also elsewhere on the board
/DRIVER & CONNECTOR/DAC2_OUT: R47.1, TP12.1 (1_1), U3.5 (+); also elsewhere on the board
/DRIVER & CONNECTOR/DRIVER_MAIN1: J9.3; also elsewhere on the board
/DRIVER & CONNECTOR/DRIVER_MAIN2: J9.11 (P111); also elsewhere on the board
/DRIVER & CONNECTOR/DRIVER_MAIN3: J9.12; also elsewhere on the board
/DRIVER & CONNECTOR/DRIVER_MAIN4: J9.13; also elsewhere on the board
/DRIVER & CONNECTOR/DRIVER_MAIN5: J9.6; also elsewhere on the board
/DRIVER & CONNECTOR/DRIVER_PUMP1: J10.3; also elsewhere on the board
/DRIVER & CONNECTOR/DRIVER_PUMP2: J10.11 (P111); also elsewhere on the board
/DRIVER & CONNECTOR/DRIVER_PUMP3: J10.12; also elsewhere on the board
/DRIVER & CONNECTOR/DRIVER_PUMP4: J10.13; also elsewhere on the board
/DRIVER & CONNECTOR/DRIVER_PUMP5: J10.6; also elsewhere on the board
/DRIVER & CONNECTOR/SPI1_CS: J17.2, TP5.1 (1_1); also elsewhere on the board
/DRIVER & CONNECTOR/SPI1_MISO: J17.5, TP8.1 (1_1); also elsewhere on the board
/DRIVER & CONNECTOR/SPI1_MOSI: J17.4, TP7.1 (1_1); also elsewhere on the board
/DRIVER & CONNECTOR/SPI1_SCK: J17.3, TP6.1 (1_1); also elsewhere on the board
/DRIVER & CONNECTOR/USART3_RX: J18.3, TP10.1 (1_1); also elsewhere on the board
/DRIVER & CONNECTOR/USART3_TX: J18.2, TP9.1 (1_1); also elsewhere on the board
/STM32/PB8: J13.3; also elsewhere on the board
/STM32/PB9: J13.4; also elsewhere on the board
/STM32/PB12: J14.3; also elsewhere on the board
/STM32/PB13: J14.4; also elsewhere on the board
CAN1_N: J9.5, J13.1, J15.1, R42.1
CAN1_P: J9.4, J13.2, J15.2, R42.2
CAN2_N: J10.5, J14.1, J16.1, R43.1
CAN2_P: J10.4, J14.2, J16.2, R43.2
GND: C16.2, C17.2, C18.2, C19.2, C20.2, J9.0 (PAD), J10.0 (PAD), J11.2, J12.2, J13.5, J14.5, J17.7, J18.1, J19.3, J20.3, R44.2, R45.2, R47.2, R48.2, R55.2, R57.2, U3.4 (V-); also elsewhere on the board
MAIN_DGND: J9.1, J9.9
MAIN_DRIVER: J9.8, J9.15; also elsewhere on the board
MAIN_TGND: J9.10
MAIN_THROTTLE: J9.14, R46.2, TP13.1 (1_1), U3.1
unnamed: J19.2, R54.1
unnamed: J20.2, R56.1
unnamed: R45.1, R46.1, U3.2 (-)
unnamed: R48.1, R49.1, U3.6 (-)
PA8: TP4.1 (1_1); also elsewhere on the board
PUMP_DGND: J10.1, J10.9
PUMP_DRIVER: J10.8, J10.15; also elsewhere on the board
PUMP_TGND: J10.10
PUMP_THROTTLE: J10.14, R49.2, TP14.1 (1_1), U3.7

Notes on the sheet:
Crossed: DNP (Do Not Place)

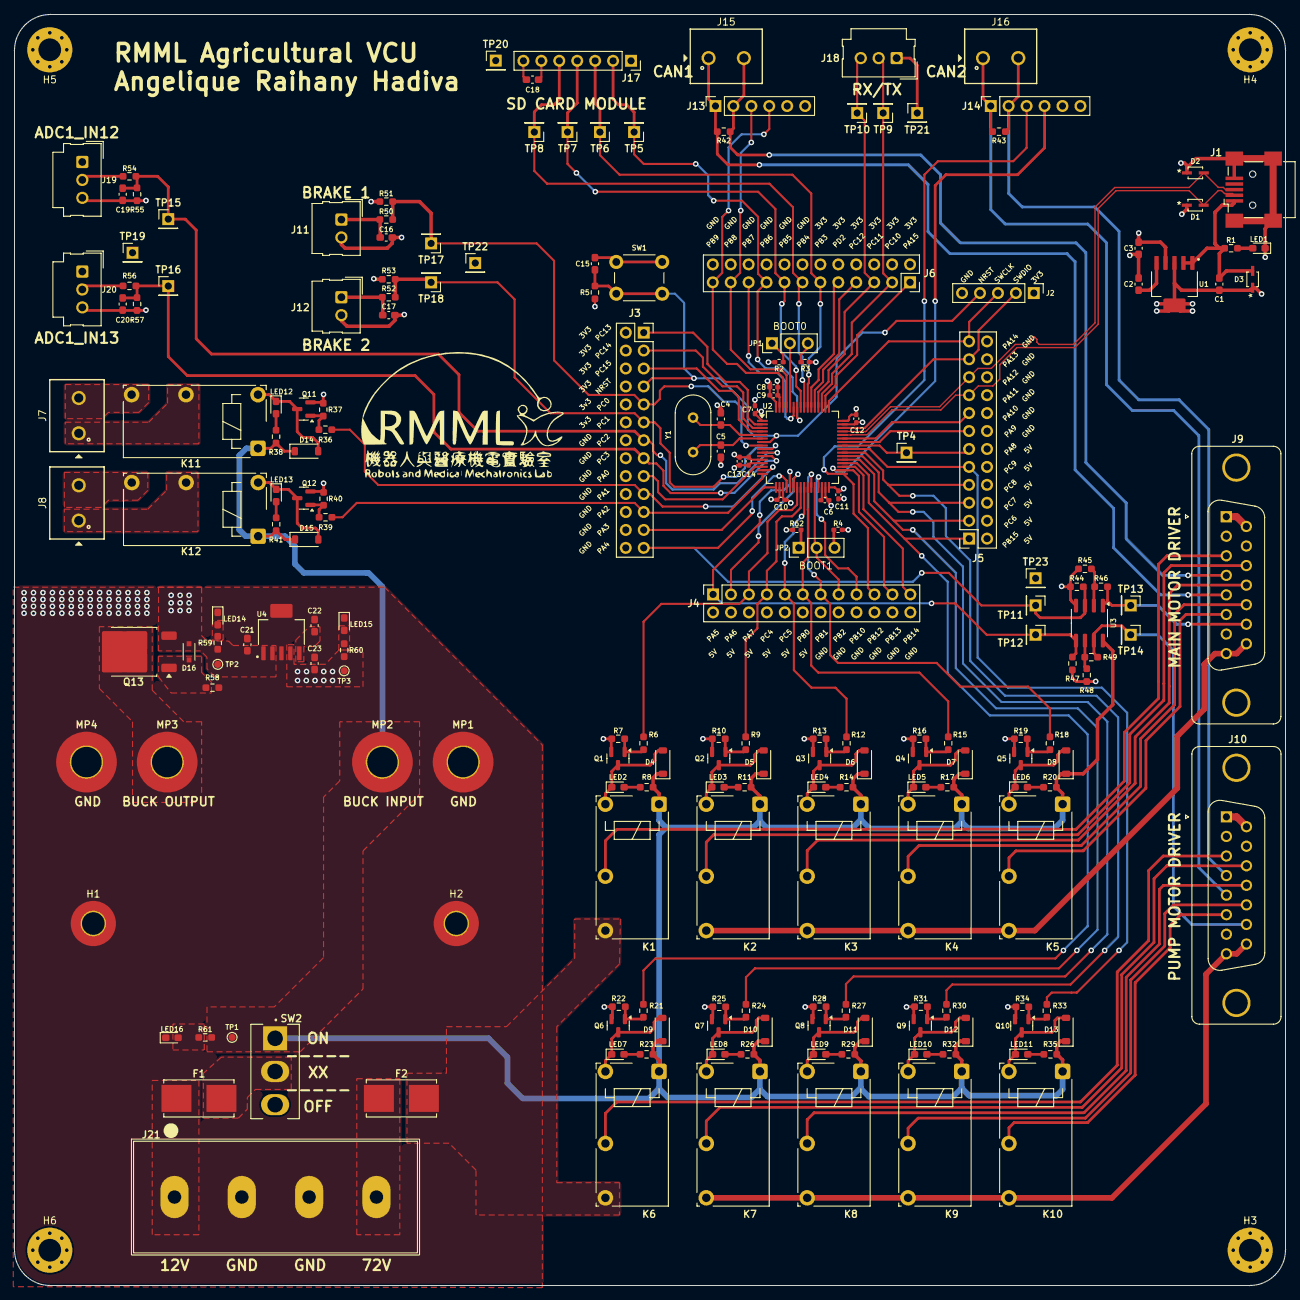
[picture p32: board Tractor VCU.kicad_pcb from above]

Board: 4 copper layers, 180.0 x 180.0 mm, 207 parts (0 on the bottom side), 140 nets.
