laurapreidewe/Agriculture-VCU_v1/(commit log)

2026-10-21 Add missing hierarchical VCU schematics
    [STM32F446RE minsys.kicad_sch, Tractor VCU.kicad_sch, VCU Connectors.kicad_sch, VCU Relays.kicad_sch, power supply.kicad_sch]
2026-10-21 Move VCU schematics to repository root
    [STM32F446RE minsys.kicad_sch, Tractor VCU.kicad_sch, VCU Connectors.kicad_sch, VCU Relays.kicad_sch, power supply.kicad_sch]
2026-10-21 Sync Tractor VCU project and manufacturing exports
    Update KiCad project files, drill maps, BOM, STEP, and ODB++ exports from the source project. Replace the Gerber directory with the original Gerber.zip archive and remove obsolete drill outputs.
    [STM32F446RE minsys.kicad_sch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]
2026-10-21 Document AgriVCU v1 hardware and printed-board VCAP repair
    Add a README covering the corrected KiCad design, required VCAP trace-cut repair for printed v1 boards, Cultivator-to-v1 revisions, interfaces, setup, and the existing STEP model. Include the original manual and revision list, and clarify the manual J17 SPI pin mapping.
